richcreations/Ghettotator/models/gallery.md

# Wire Wiggler Gallery
## Prototype Build
Some photos taken while testing the prototype:

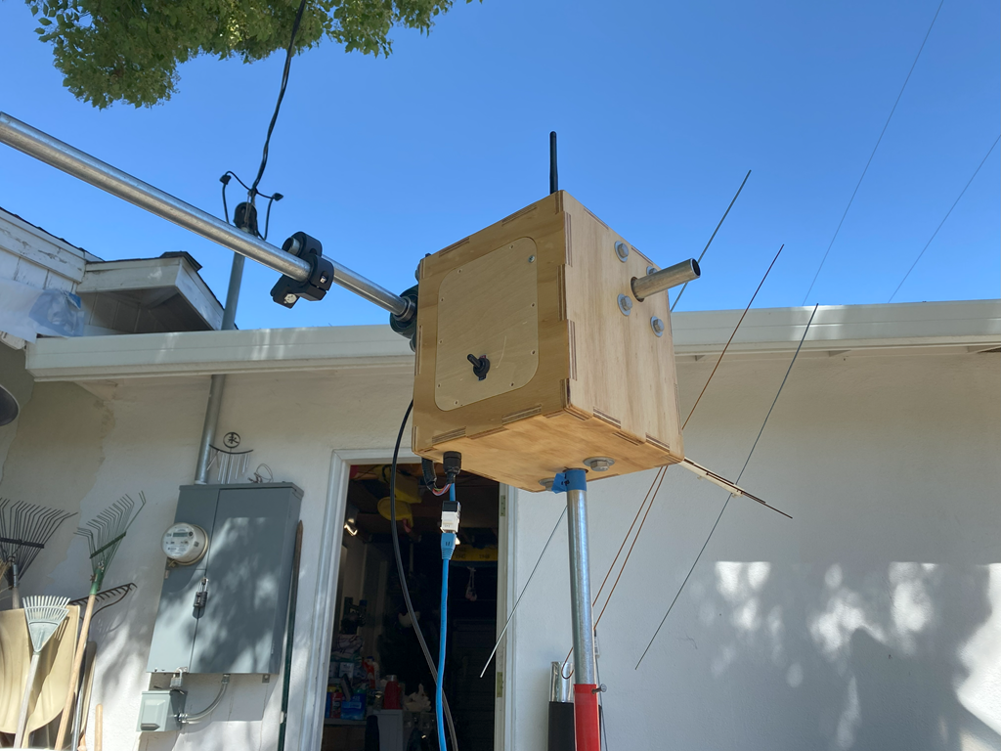
[picture p2: images/refDesBuild2.png]




Photos taken during the prototype build process:

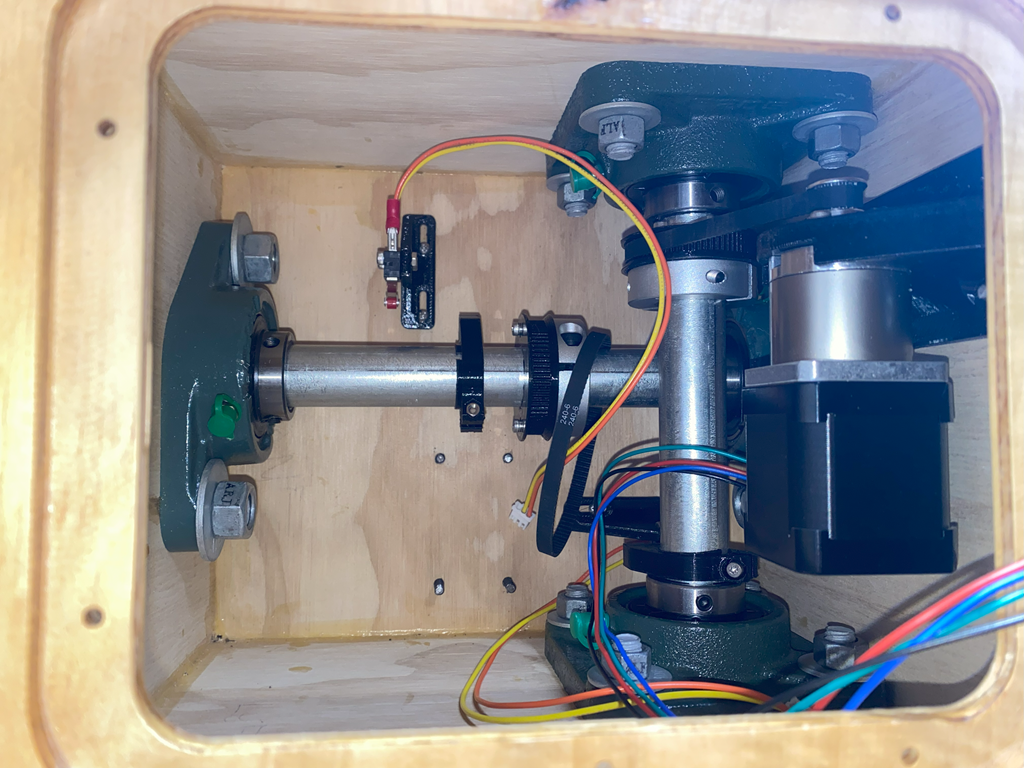
[picture p3: images/refDesBuild1.png]


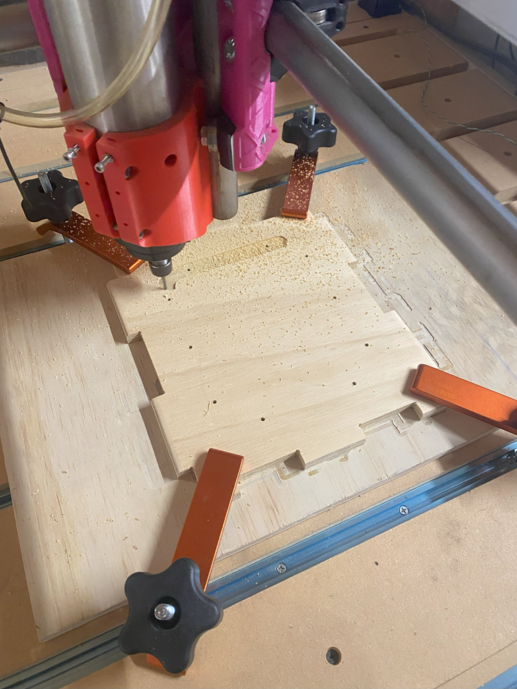
[picture p4: images/refDesCNC1.png]


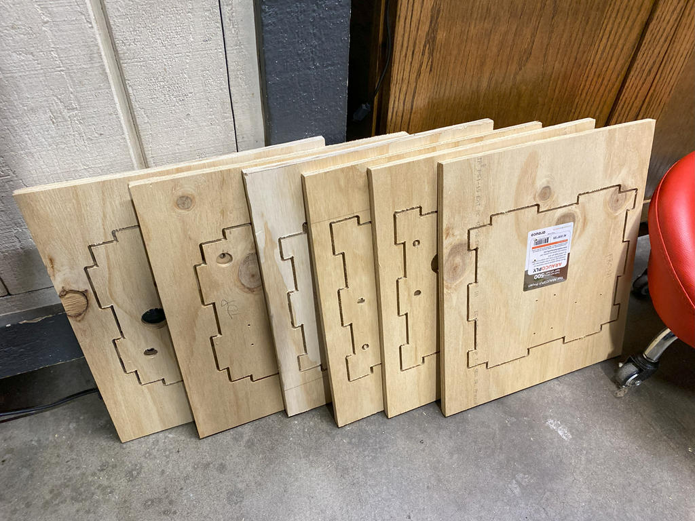
[picture p5: images/refDesCNC2.png]


## Design Renderings (Fusion360)
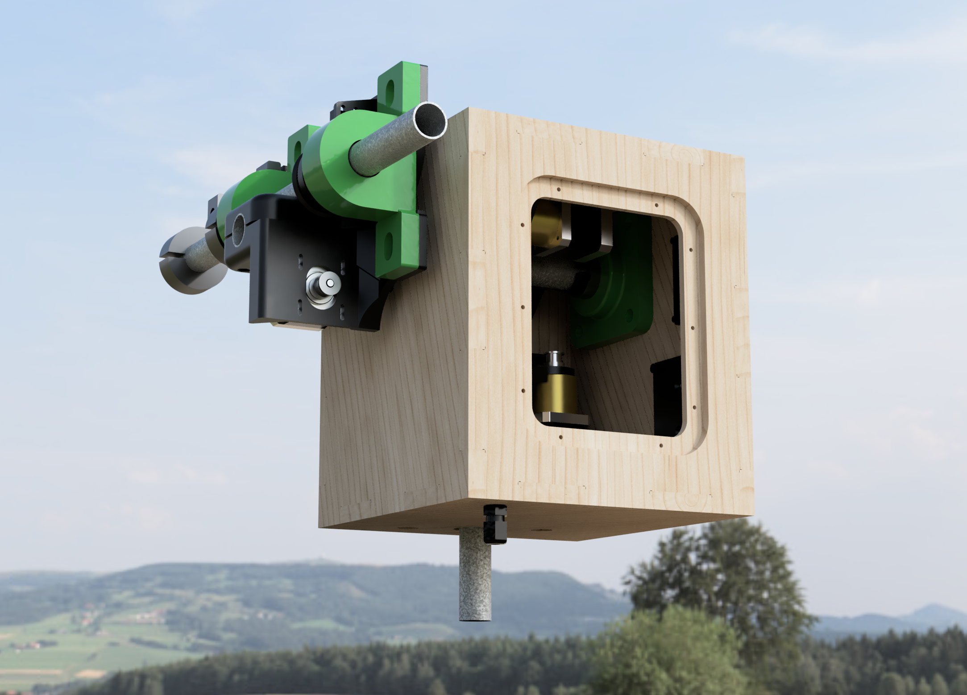
[picture p6: images/wigglerReferenceDesign1.png]


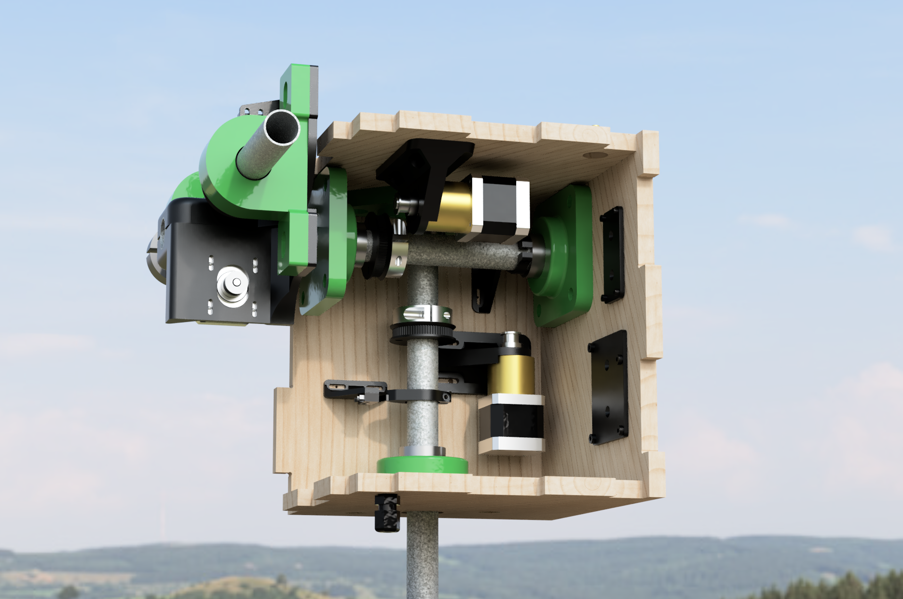
[picture p7: images/wigglerReferenceDesign2.png]


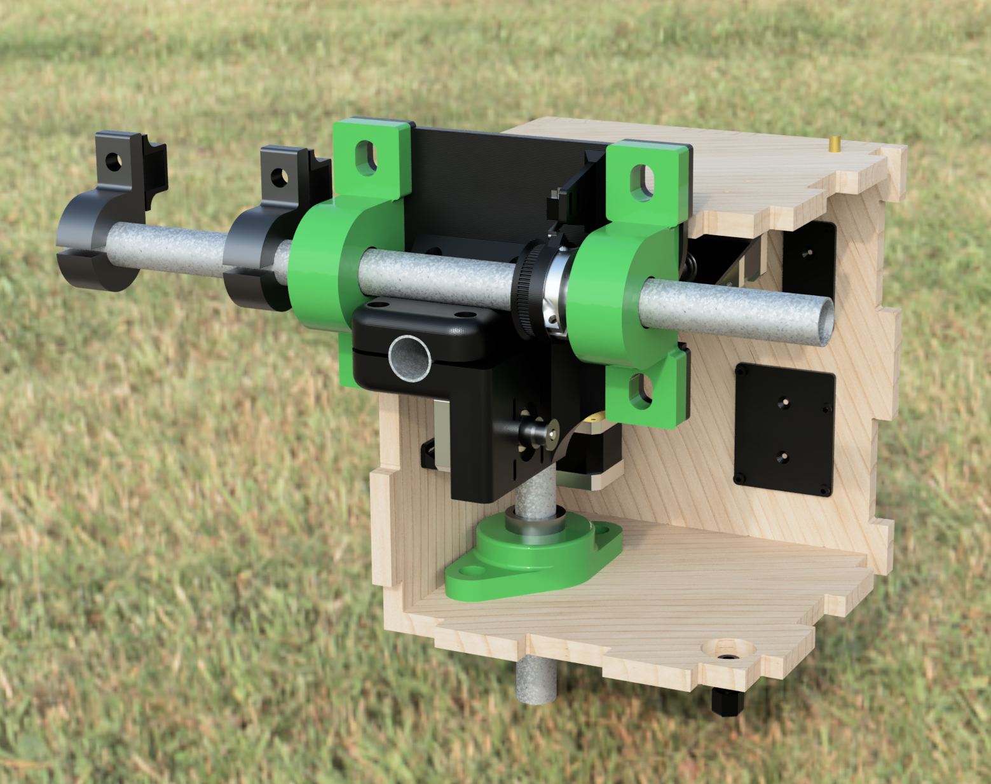
[picture p8: images/wigglerReferenceDesign3.png]
