richcreations/Ghettotator/images/nanoCNCv4-boardTop.jpg

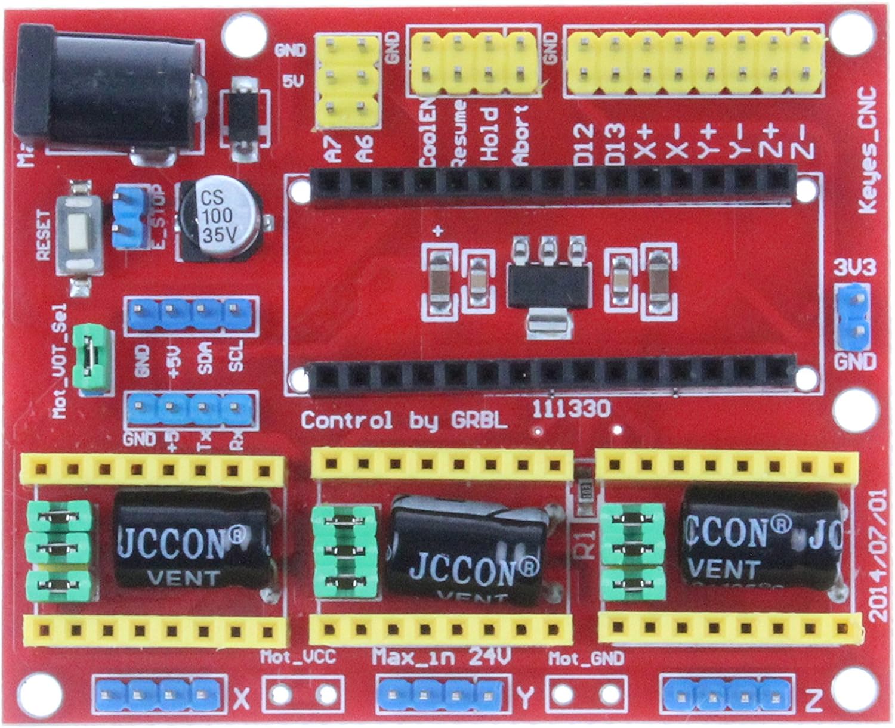
images/nanoCNCv4-boardTop.jpg
