richcreations/Ghettotator/images/nanoCNCv4-fixed.png

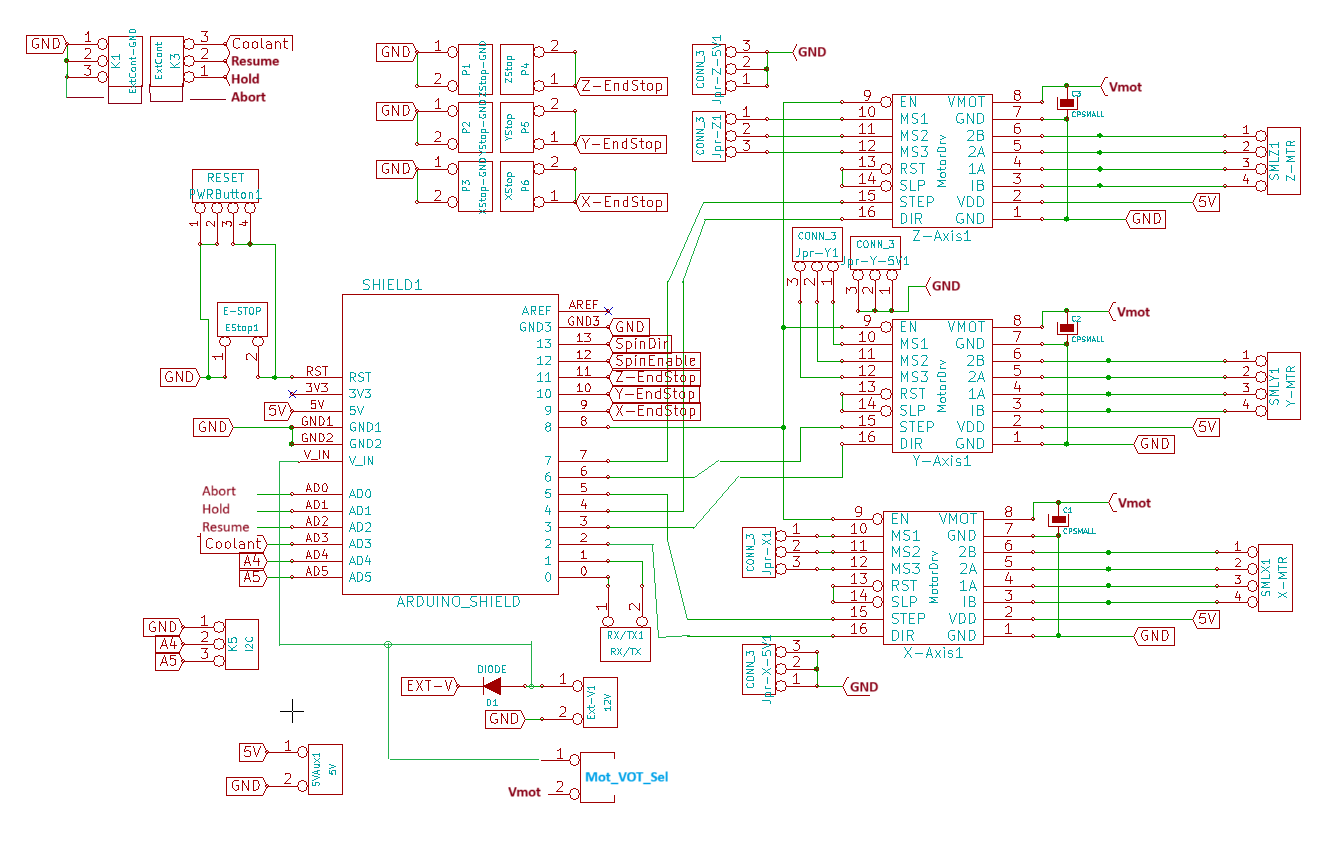
images/nanoCNCv4-fixed.png
