richcreations/Ghettotator/images/unoCNCv3-board.webp

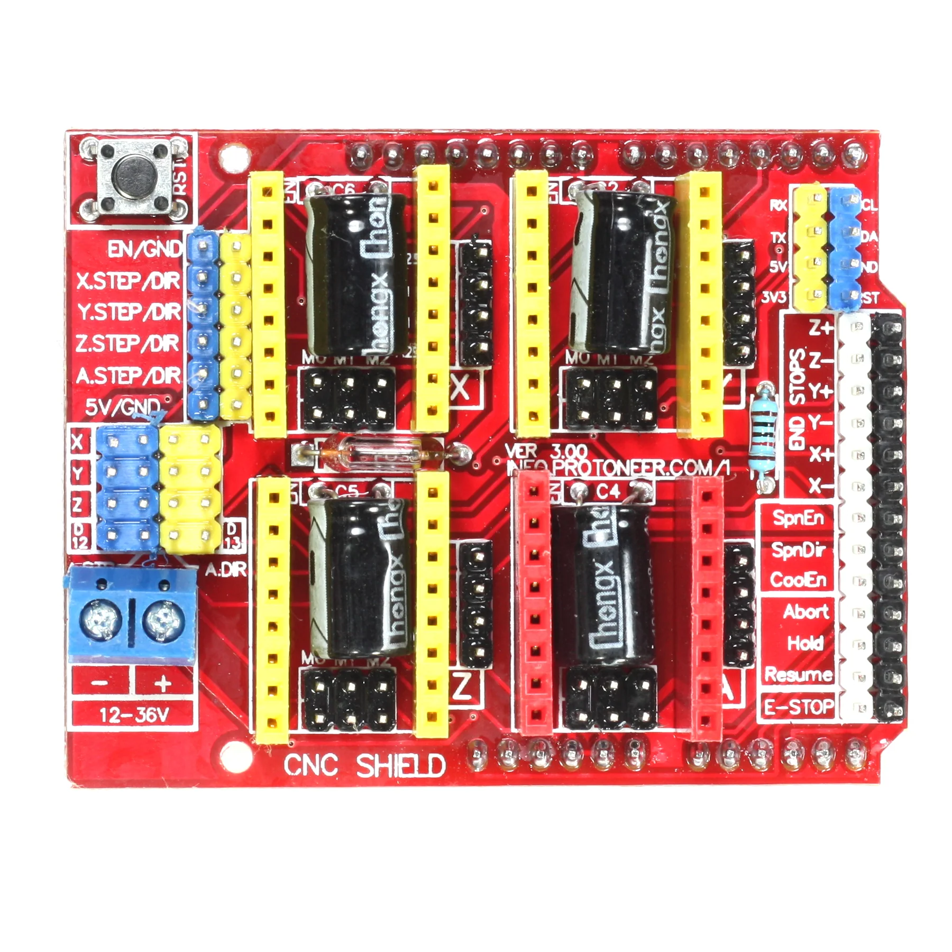
images/unoCNCv3-board.webp
