richcreations/Ghettotator/images/unoCNCv3.png

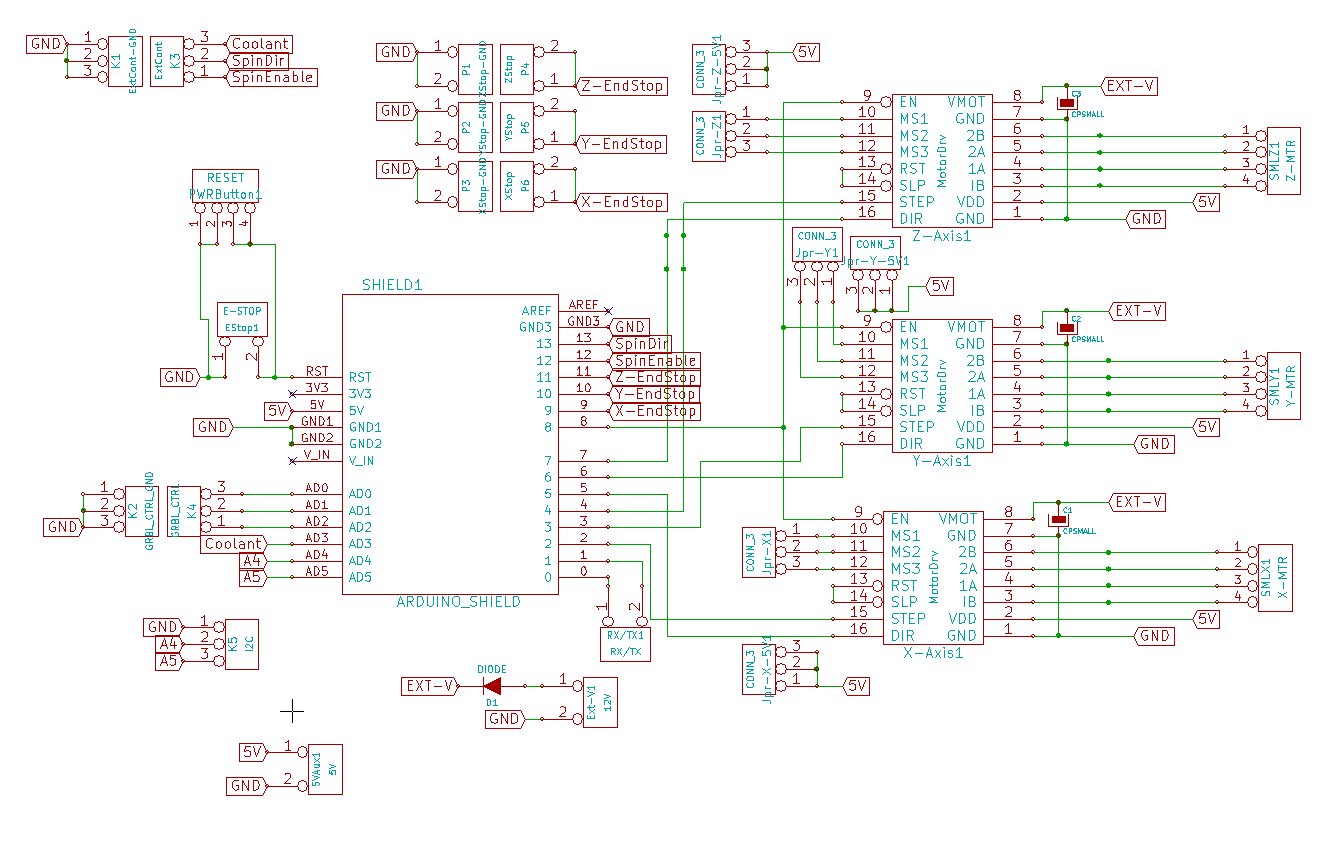
images/unoCNCv3.png
