richcreations/Ghettotator/models/bottom.stl

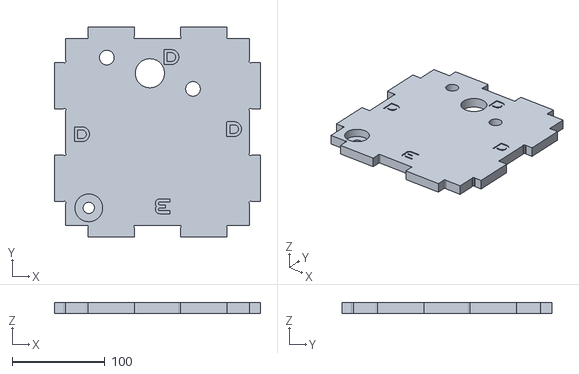
[picture p13: CAD file, 2024-05-05]
models/bottom.stl
221.9 x 225.7 x 11.9
