richcreations/Ghettotator/models/door.stl

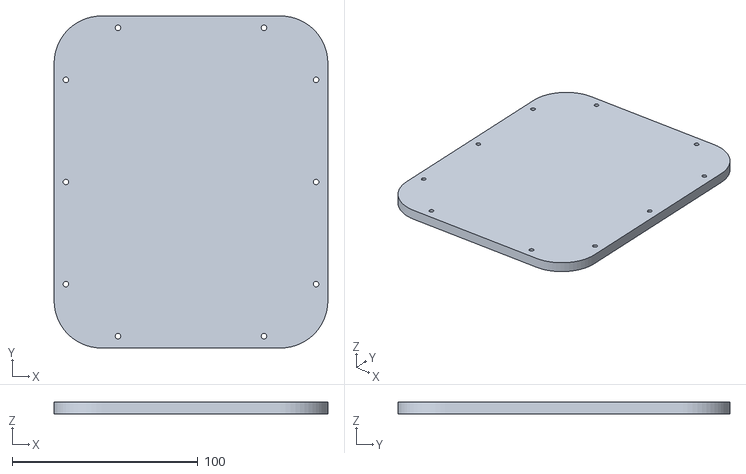
[picture p14: CAD file, 2024-05-05]
models/door.stl
147.2 x 178.5 x 6.35
