richcreations/Ghettotator/models/right.stl

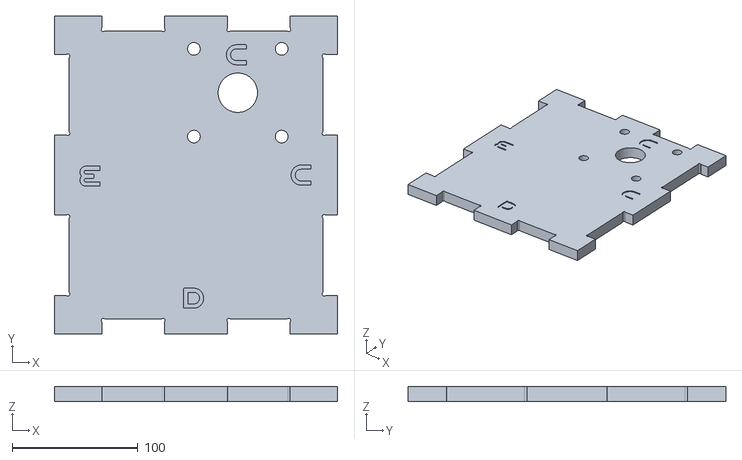
[picture p15: CAD file, 2024-05-05]
models/right.stl
225.7 x 253.2 x 11.9
