richcreations/Ghettotator/models/back.stl

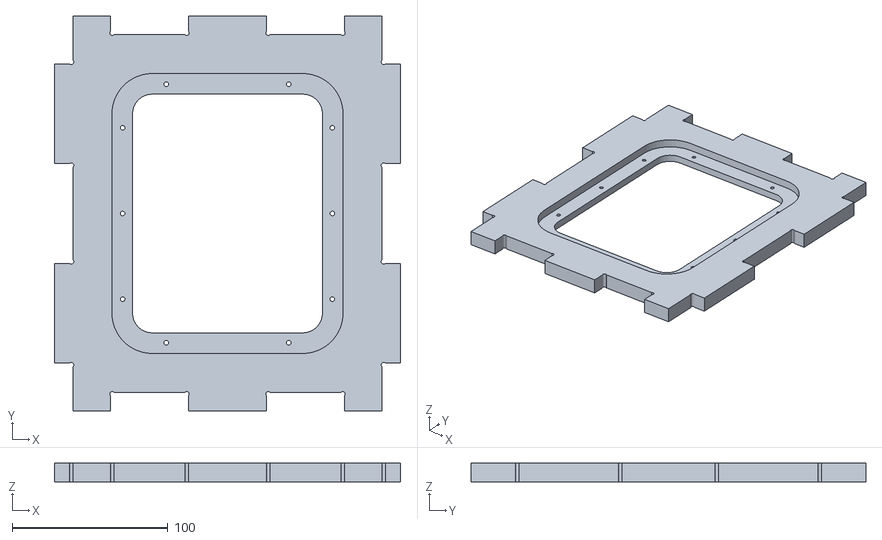
[picture p16: CAD file, 2024-05-05]
models/back.stl
221.9 x 253.2 x 11.9
