richcreations/Ghettotator/models/front.stl

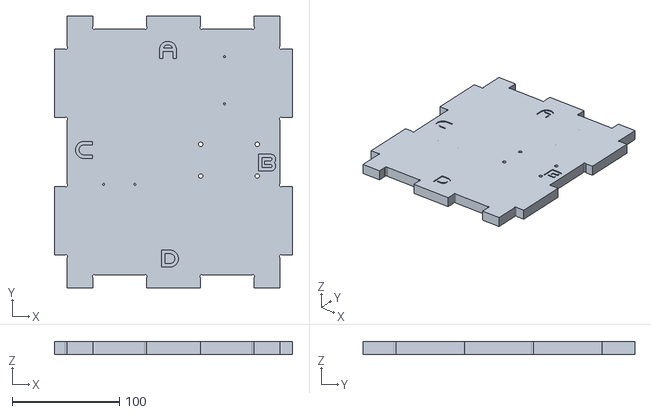
[picture p17: CAD file, 2024-05-05]
models/front.stl
221.9 x 253.2 x 11.9
