richcreations/Ghettotator/models/antennaAdapter.stl

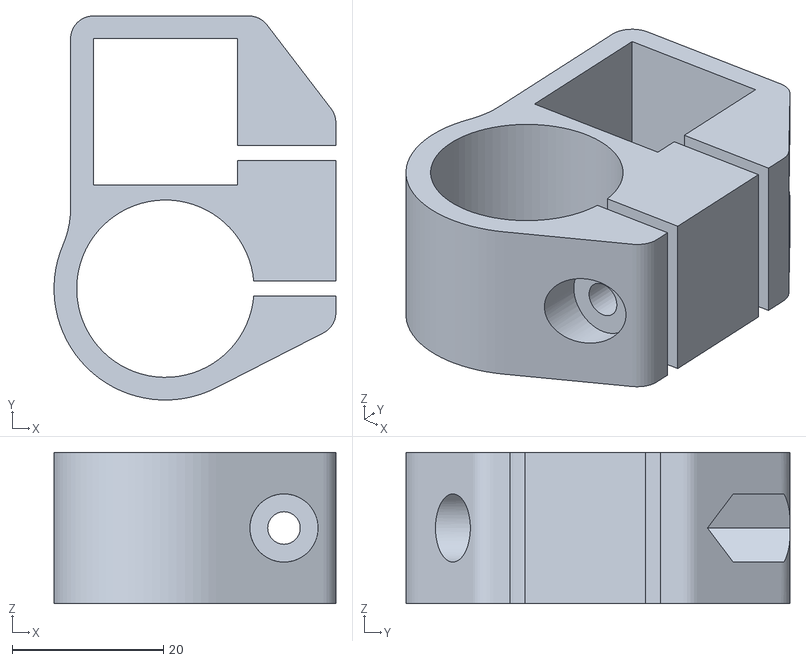
[picture p18: CAD file, 2024-05-04]
models/antennaAdapter.stl
37.2 x 50.7 x 20.0
