richcreations/Ghettotator/models/controlBoxTop.stl

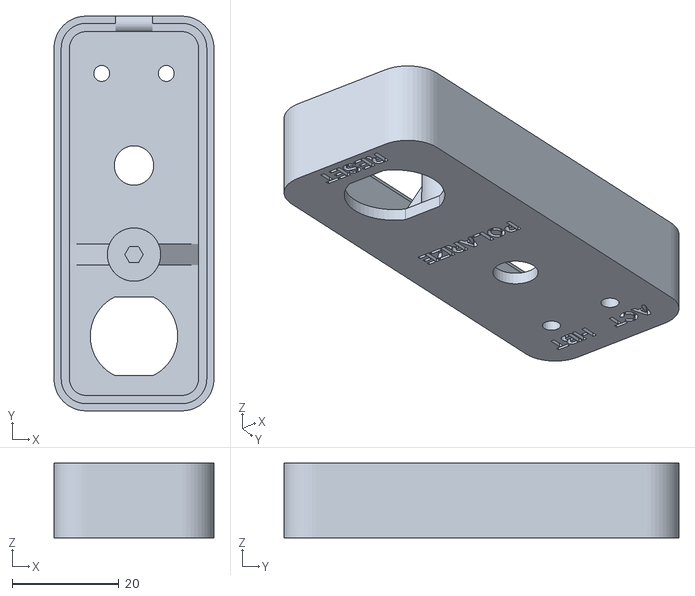
[picture p19: CAD file, 2024-05-04]
models/controlBoxTop.stl
30.0 x 74.0 x 14.0
