richcreations/Ghettotator/models/piZeroMount.stl

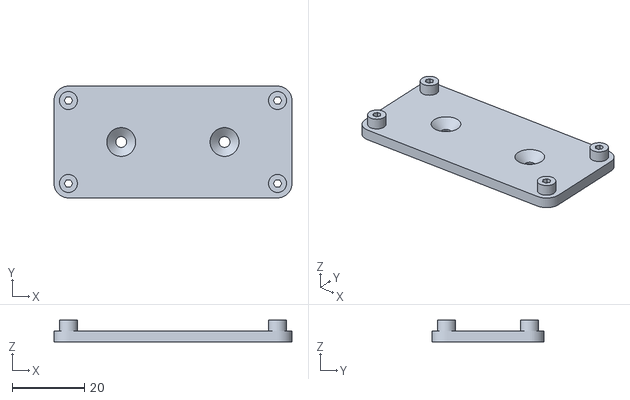
[picture p20: CAD file, 2024-04-29]
models/piZeroMount.stl
66.0 x 31.0 x 6.00
