richcreations/Ghettotator/models/polEndstopCam.stl

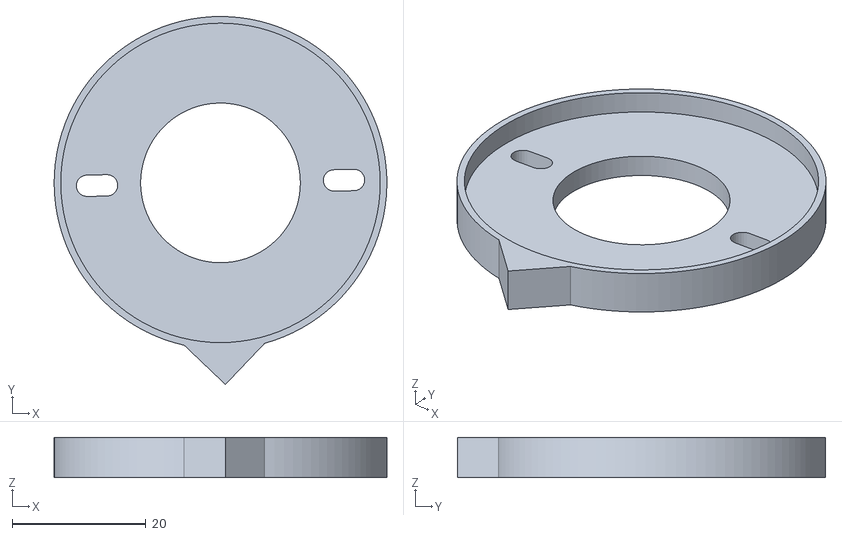
[picture p21: CAD file, 2024-04-29]
models/polEndstopCam.stl
49.8 x 55.1 x 6.00
