richcreations/Ghettotator/models/nanoCNCv4Base.stl

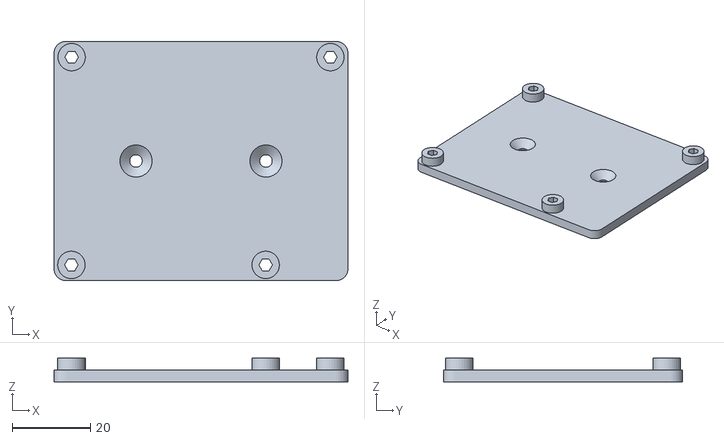
[picture p22: CAD file, 2024-04-29]
models/nanoCNCv4Base.stl
75.0 x 61.0 x 6.00
