richcreations/Ghettotator/models/drillGuidePulleyClamp.stl

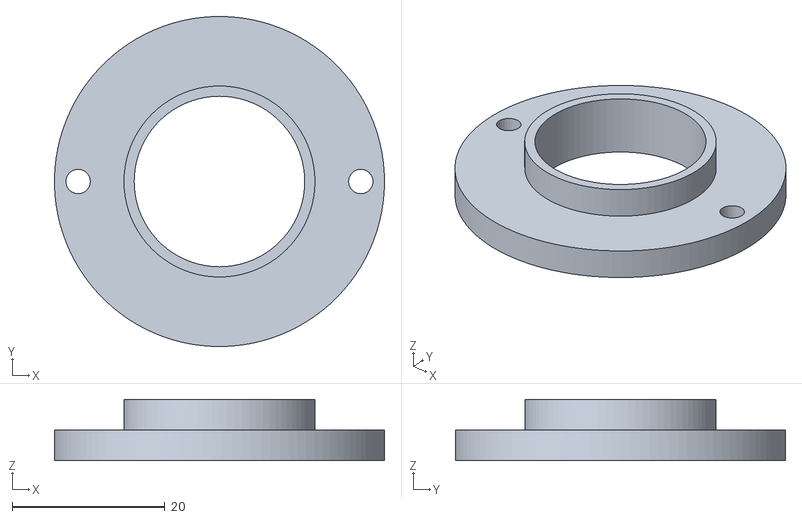
[picture p23: CAD file, 2024-04-29]
models/drillGuidePulleyClamp.stl
43.2 x 43.2 x 8.00
