richcreations/Ghettotator/models/aziEndstopMountPrint.stl

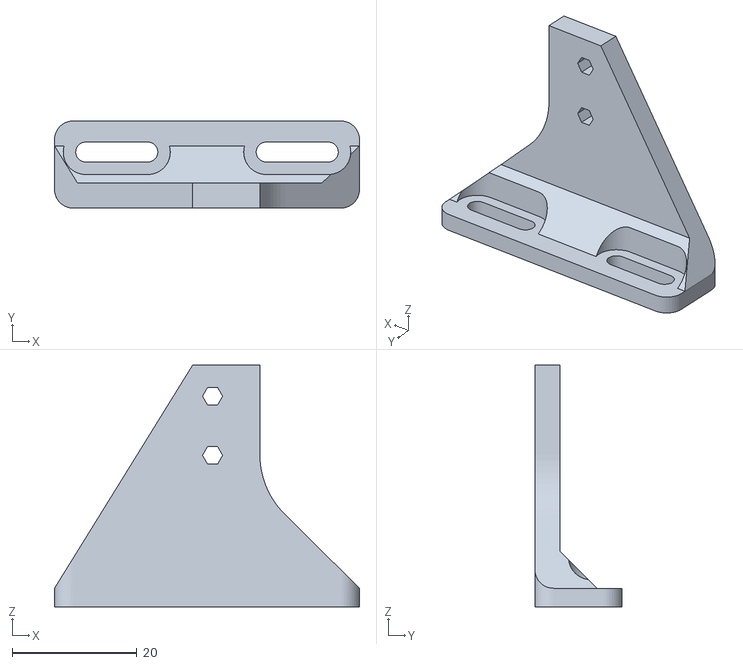
[picture p24: CAD file, 2024-04-29]
models/aziEndstopMountPrint.stl
49.0 x 14.0 x 38.9
