richcreations/Ghettotator/models/pulley1inch72T.stl

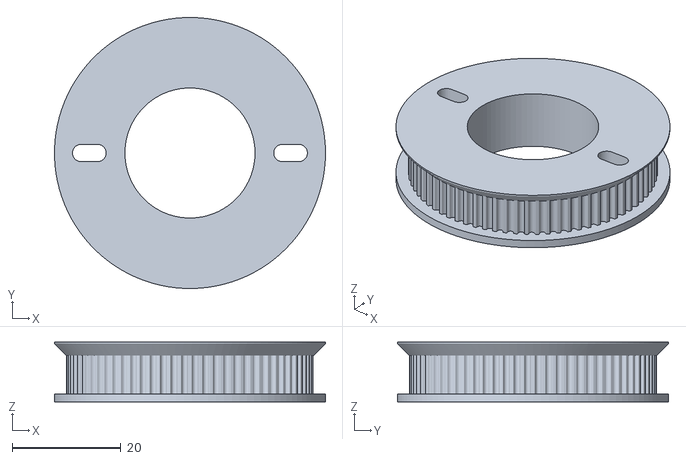
[picture p25: CAD file, 2024-04-29]
models/pulley1inch72T.stl
49.8 x 49.8 x 11.0
