richcreations/Ghettotator/models/aziEleEndstopCam.stl

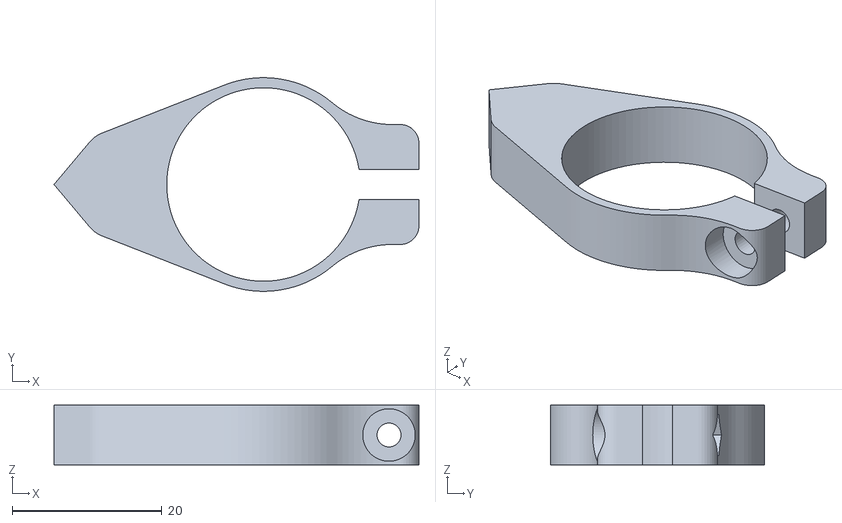
[picture p26: CAD file, 2024-04-29]
models/aziEleEndstopCam.stl
48.7 x 28.5 x 8.00
