richcreations/Ghettotator/models/controlBoxBottom.stl

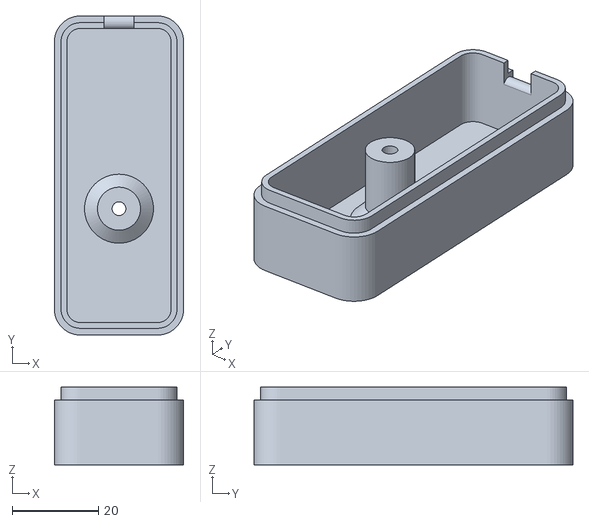
[picture p27: CAD file, 2024-04-29]
models/controlBoxBottom.stl
30.0 x 74.0 x 18.0
