richcreations/Ghettotator/models/aziMountPrint.stl

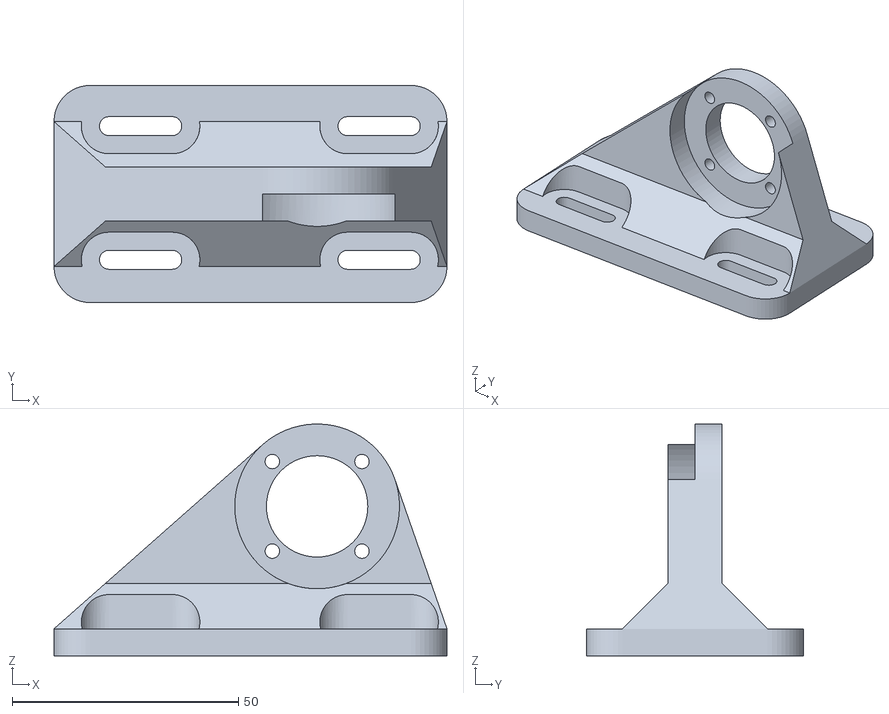
[picture p28: CAD file, 2024-04-29]
models/aziMountPrint.stl
86.9 x 48.0 x 51.2
