richcreations/Ghettotator/models/polMountBottom.stl

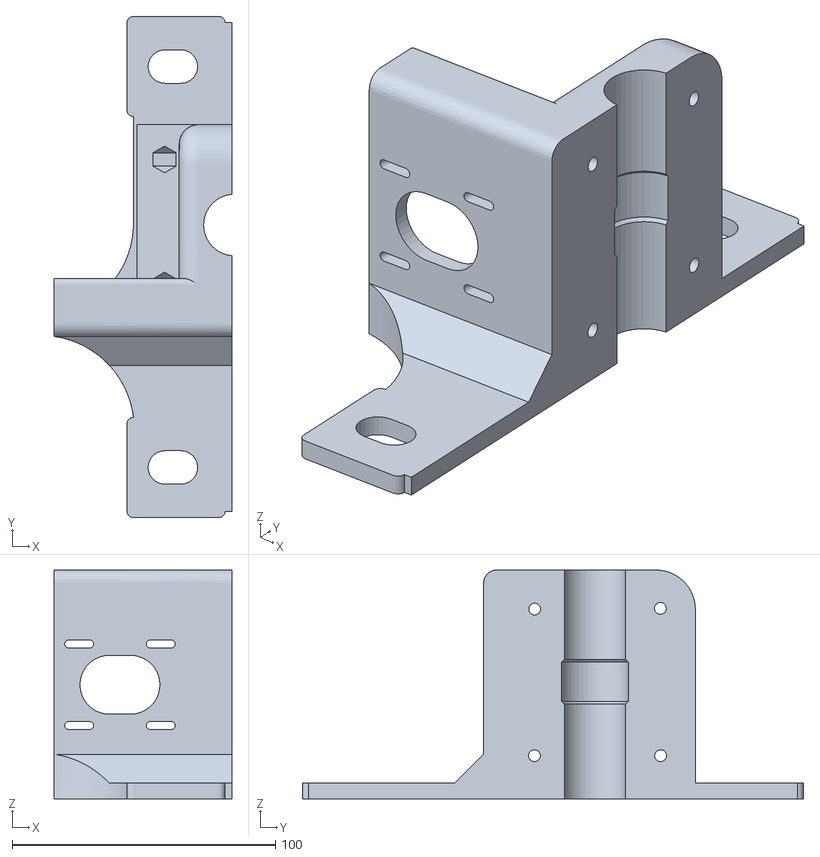
[picture p29: CAD file, 2024-04-29]
models/polMountBottom.stl
67.5 x 190.4 x 87.0
