richcreations/Ghettotator/models/shimEndstopCam.stl

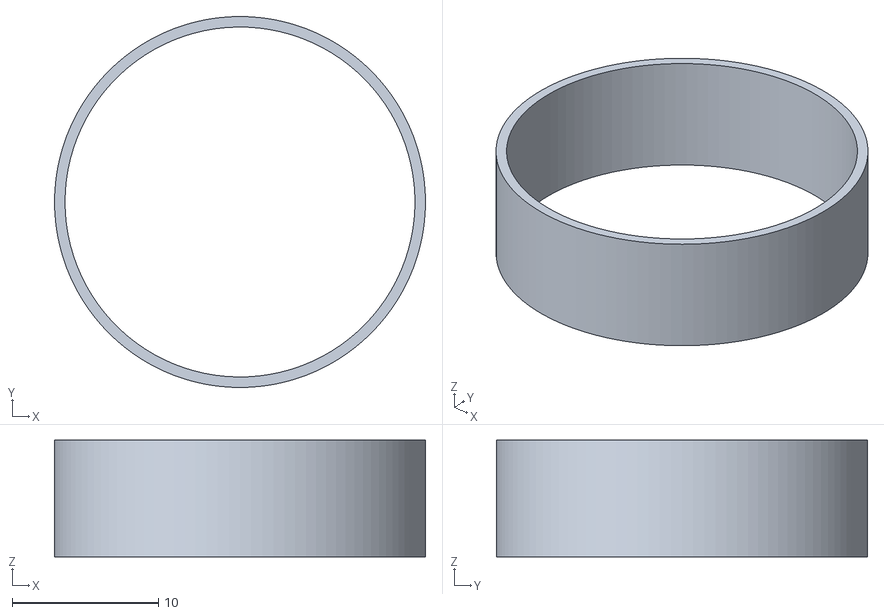
[picture p30: CAD file, 2024-04-29]
models/shimEndstopCam.stl
25.4 x 25.4 x 8.00
