richcreations/Ghettotator/models/eleMountPrint.stl

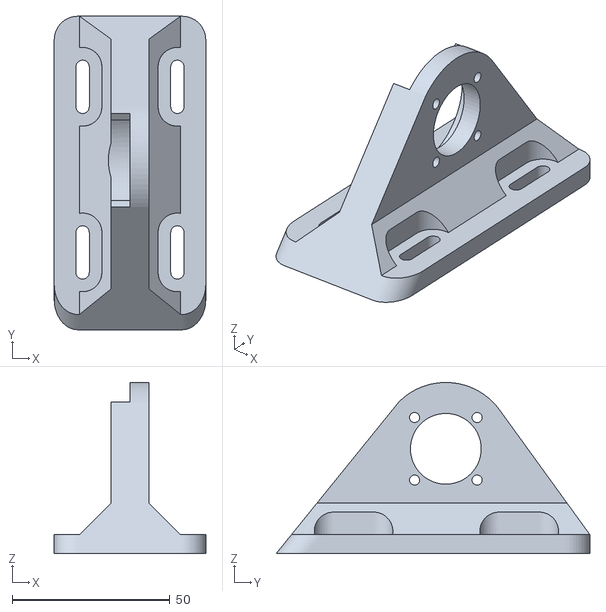
[picture p31: CAD file, 2024-04-29]
models/eleMountPrint.stl
48.0 x 99.3 x 54.1
