richcreations/Ghettotator/models/shimPillowBlock.stl

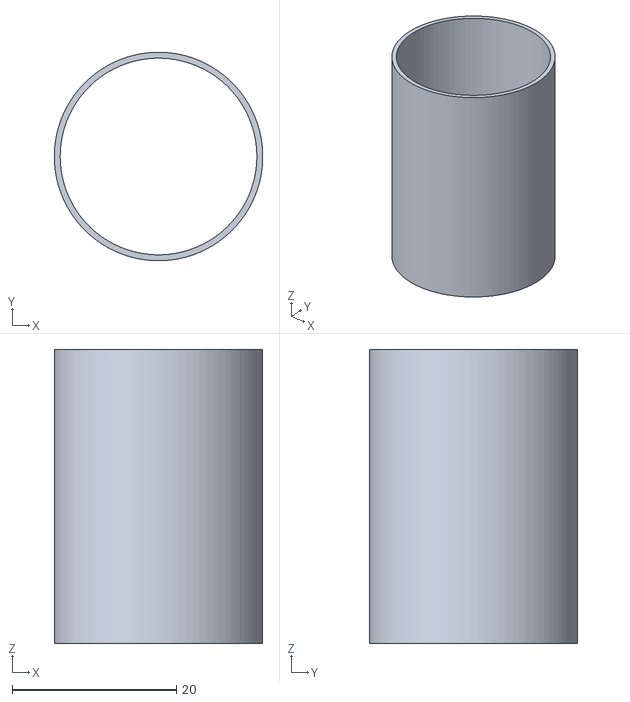
[picture p32: CAD file, 2024-04-29]
models/shimPillowBlock.stl
25.4 x 25.4 x 35.8
