richcreations/Ghettotator/models/eleEndstopMountPrint.stl

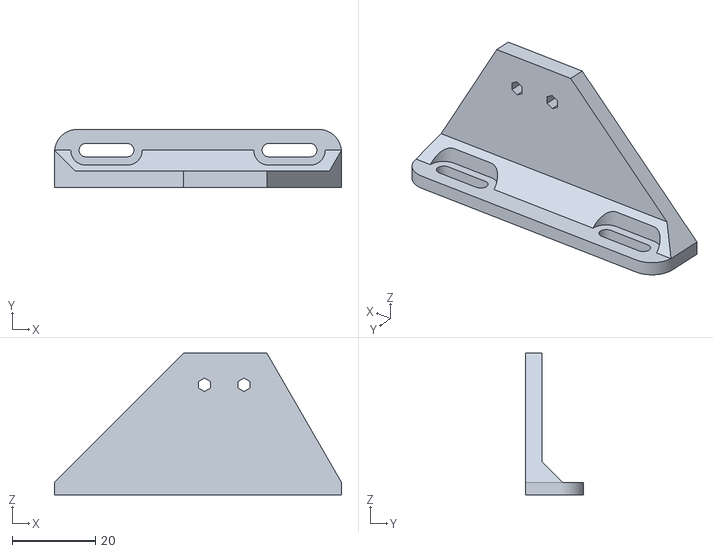
[picture p33: CAD file, 2024-04-29]
models/eleEndstopMountPrint.stl
69.0 x 14.0 x 34.1
