richcreations/Ghettotator/models/shimPulleyClamp.stl

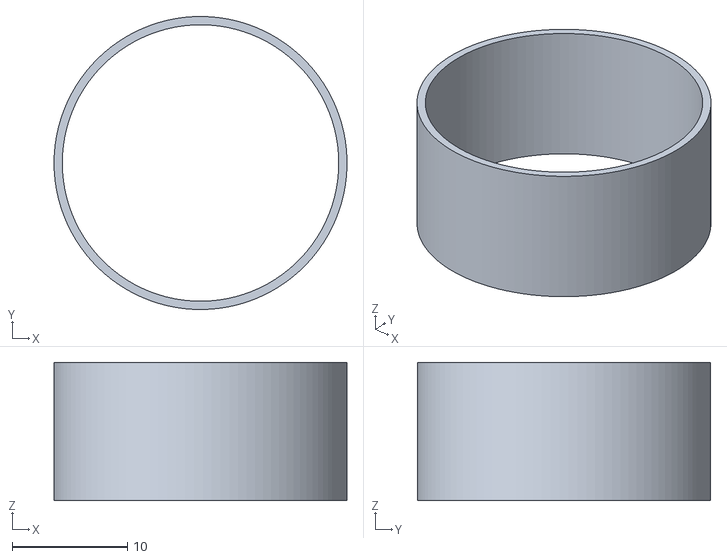
[picture p34: CAD file, 2024-04-29]
models/shimPulleyClamp.stl
25.4 x 25.4 x 12.0
