richcreations/Ghettotator/models/shimEleEndstopMount.stl

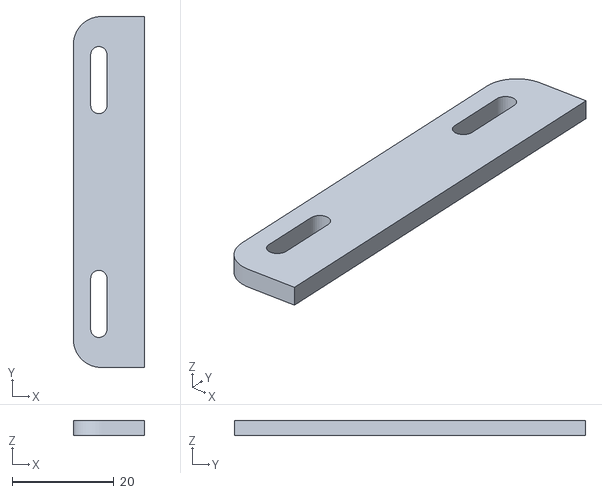
[picture p35: CAD file, 2024-04-29]
models/shimEleEndstopMount.stl
14.0 x 69.0 x 3.00
