richcreations/Ghettotator/models/polMountTop.stl

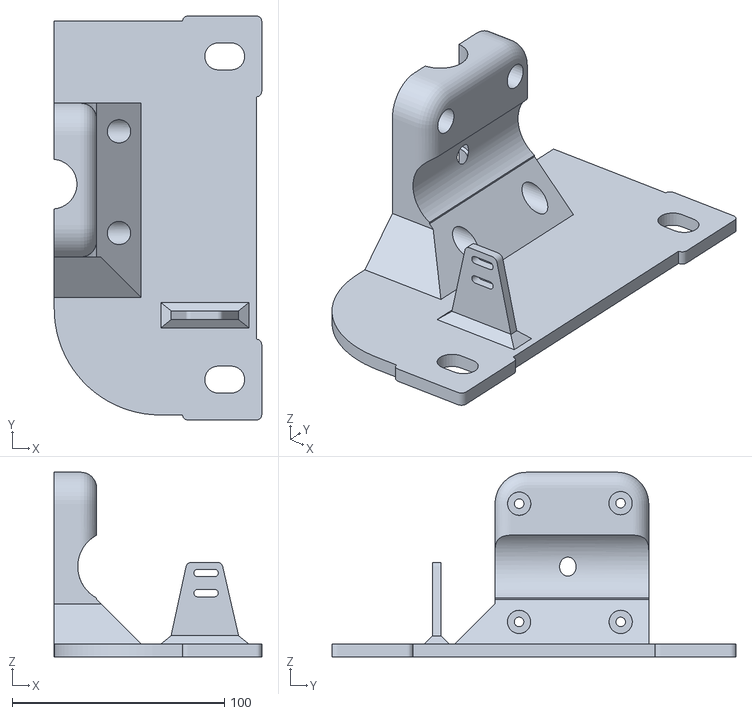
[picture p36: CAD file, 2024-04-29]
models/polMountTop.stl
97.8 x 190.5 x 87.0
