richcreations/Ghettotator/(list of files, cad)

Other CAD files:
models/top.stl
models/left.stl
