richcreations/Ghettotator/(commit log)

2024-04-03 remove motors, use "min" for endstops
2024-04-03 fix more variable names
    [config.h, stepper_motor_controller.cpp]
2024-04-03 added debug led, fixed issues from initial hardware test
    [anet_a8_atmega1280.h, config.h, ramps_V_1_4.h, stepper_motor_controller.cpp, unoCncV3.h]
2024-04-04 homing test successful
2024-04-04 Fixed watchdog timer, removed unused items, misc cleanup
    [anet_a8_atmega1280.h, config.h, ramps_V_1_4.h, stepper_motor_controller.cpp, unoCncV3.h]
2024-04-04 fixed cnc shield enable pins
    [unoCncV3.h]
2024-04-04 added pin file descriptions
2024-04-04 add fast blink during homing, fix watchdog, move baud to config
    [config.h, stepper_motor_controller.cpp]
2024-04-04 Update stepper_motor_controller.cpp
    Moved pins include to config.h
2024-04-05 append Pin to pin vars
2024-04-05 fixed watchdog vars... weird
    [config.h, stepper_motor_controller.cpp]
2024-04-05 fix comments, degrees need floats so use floats, fix some type casts, removed uneeded vars
    [config.h, stepper_motor_controller.cpp]
2024-04-05 added custom board option
2024-04-05 add board images
2024-04-05 change HOME_DELAY defaults, fix type on defaults.h, touch up readme
    [config.h]
2024-04-05 fix var name in conversion functions
    [wire-wiggler.cpp]
2024-04-05 make ledExists a compile time macro
2024-04-05 remove t_run var, remove SAMPLE_TIME, start adding parking feature, fix missing MIN_PULSE_WIDTH
    [config.h, wire-wiggler.cpp]
2024-04-06 ditch a8 board, add warnings about >4 microsteps
2024-04-06 add microstepping error message
    [config.h, wire-wiggler.cpp]
2024-04-06 fixed mega board in platform.ini
2024-04-06 fixed float definitions for non-float vars, changed readpolpot method, more sane defaults based on 2560 testing
    [config.h, wire-wiggler.cpp]
2024-04-06 make polpot sample count a define
2024-04-06 add LED info to readme troubleshooting
2024-04-06 fix type casting, remove references to microstep limits
    [config.h, ramps_V_1_4.h, unoCncV3.h, wire-wiggler.cpp]
2024-04-06 fix pin order for mega to make more sense
    [ramps_V_1_4.h]
2024-04-06 readd anet a8 board
2024-04-06 add compiler error for a8 microsteps
    [config.h]
2024-04-07 update readme and comments, remove rolling average, modify platformio.ini to stop annoying warning about UNO not having an A8 pin.
2024-04-07 add support for teensy 4.0 and 3.2 boards, add macro so WATCHDOG is not used for teensy boards
2024-04-09 fix watchdog define order, more sane default rates
    [config.h]
2024-04-10 fix type in config.h
    [config.h]
2024-04-10 mpu6050 and hmc5883 add configs and drivers
2024-04-12 add nano cnc v3 board
2024-04-15 make all motors capable of nano microstep warnings, comment on shield pin for external heartbeat LED
2024-04-16 use float values to init float vars, correct led flashing rates in readme
    [wire-wiggler.cpp]
2024-04-16 change pol defaults for 16T pulley
2024-04-16 fixed pol rolling avg
    [wire-wiggler.cpp]
2024-04-29 fix rolling average, again lol
    [config.h, wire-wiggler.cpp]
2024-04-29 upload reference design files
    [antAdapter075square.stl, aziEleEndstopCam.stl, aziEndstopMountPrint.stl, aziMountPrint.stl, controlBoxBottom.stl, controlBoxTop.stl, drillGuidePulleyClamp.stl, eleEndstopMountPrint.stl]
2024-04-30 add reference design bom, reduce default accel from 120 to 20, add external heartbeat led pins, add option to use either internal or external led
2024-04-30 change default nano external led pin for easier assembly
2024-04-30 add homing switch check and back off routine
2024-04-30 fix homing switch check
    [wire-wiggler.cpp]
2024-04-30 clean up homing and main loop
2024-04-30 more homing fixes and cleanup
    [wire-wiggler.cpp]
2024-05-03 reduce home delay, add antenna adapter model
    [wigglerAntennaAdapter-conduit-075.stl]
2024-05-04 update readme, upload revised controlBoxTop model
    [controlBoxTop.stl]
2024-05-04 update antennaAdapter model
    [antennaAdapter.stl, wigglerAntennaAdapter-conduit-075.stl]
2024-05-04 antennaAdapter revision uploaded, clean up referenceDesign.md
    [antennaAdapter.stl]
2024-05-04 initial fleshing of ref design readme
    [antAdapter075square.stl]
2024-05-05 swap box gcode files with stl
    [back.stl, bottom.stl, door.stl, front.stl, left.stl, right.stl, top.stl]
2026-05-16 fix undeclared isHome_po in non-POLARIZER homing
    The #ifndef POLARIZER homing function referenced isHome_po in its
    while loop condition, but that variable is only declared in the
    #else (POLARIZER) branch. Removed it from the non-POLARIZER loop.
    [wire-wiggler.cpp]
2026-05-16 refactor LED blink logic into ledBlink/ledOn helpers
    The same 15-line blink block was copy-pasted 4 times in homing and
    twice more in loop. Extracted into ledBlink(period) and ledOn()
    helpers guarded by the existing LED feature macros.
2026-05-16 add native unit tests for deg2step and step2deg
    Extract math functions into lib/rotator_math.h so they can be tested
    without Arduino dependencies. Add PlatformIO native env and 12 Unity
    tests covering zero, known values, microstep scaling, and round-trips.
2026-05-16 clamp az/el setpoints to configured angle limits
    Commands received via EasyComm are now clamped to AZI_MIN_ANGLE/
    AZI_MAX_ANGLE and ELE_MIN_ANGLE/ELE_MAX_ANGLE before being accepted,
    preventing out-of-range commands from driving the rotator past its
    mechanical limits.
2026-05-16 replace String heap allocations with direct Serial.print calls
    Every serial response was building 3-5 String objects on the heap
    before sending. Replaced with direct Serial.print() calls and a
    printAzEl() helper for the repeated AZ/EL position response.
    Saves 4KB of flash and eliminates heap fragmentation risk.
2026-05-16 implement speed control mode for VU/VD/VL/VR commands
    Add deg2step_f() float variant to rotator_math.h for speed conversion.
    Restructure main loop to branch on control_mode: speed mode uses
    AccelStepper setSpeed()/runSpeed() with angle limit enforcement, position
    mode keeps existing moveTo()/run() behaviour. Also removes POLARIZER
    code duplication in the motor movement section. 4 new tests for deg2step_f.
2026-05-16 dead code cleanup, implement speed and temperature reporting
    Remove unused field u from _control struct and SAMPLE_TIME define.
    Implement axis speed calculation (input_prv now used, IP7/IP8 now
    return real values). Implement AVR internal temperature sensor reading
    every 5s so IP0 reports actual board temperature.
2026-05-16 sync easycomm_dev.h with easycomm.h, update README
    easycomm_dev.h now fully matches easycomm.h (Serial.print refactor,
    setpoint clamping, printAzEl helper) with the only difference being
    the non-blocking if instead of while. README updated with speed
    control, angle clamping, and temperature features, and corrects the
    baud rate from 9600 to 57600.
2026-05-16 remove unused Adafruit library deps from platformio.ini
    COMPASS and IMU_FEEDBACK are disabled in config.h so HMC5883, MPU6050,
    BusIO, Unified Sensor, GFX, SSD1306, SPI and Wire were all being
    downloaded and linked for nothing. Left as commented hints for users
    who enable those features.
2026-05-16 remove COMPASS and IMU_FEEDBACK features entirely
2026-05-17 add experimental IMU feedback for moving platform tracking
    Adds Madgwick 9DOF AHRS filter that corrects commanded AZ/EL for
    platform tilt and heading in real time. Supports two IMU/mag combos:
    ICM-20948 + AK09916, and MPU-6050 + HMC5883L. All drivers are
    register-level Wire only — no external IMU libraries needed.
    Feature is disabled by default; enable IMU_FEEDBACK in config.h.
    - lib/imu.h: RawIMU/RawMag structs, MadgwickFilter class with NED
    frame correctAzEl() coordinate transform
    - lib/icm20948.h: ICM-20948 driver with AK09916 I2C master polling
    - lib/ak09916.h: AK09916 register constants
    - lib/mpu6050.h: MPU-6050 driver with HMC5883L I2C master polling
    - lib/hmc5883l.h: HMC5883L reg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
    [config.h]
2026-05-17 fix three bugs found in code review
    - easycomm: make buffer[] static so partial commands are not lost
    between loop iterations when BufferIndex is also static
    - wire-wiggler: guard imuDevice.read() return value — only call
    madgwick.update() when a new sample is ready, preventing garbage
    data from corrupting the quaternion estimate
    - wire-wiggler: guard readPolPot() declaration and definition with
    #ifdef POLARIZER since it uses symbols only defined in that branch
    [wire-wiggler.cpp]
